1491407/EUSS_TFG_2021-2022/README.md

# TFG
Repositirio del TFG (Trabajo Fin de Grado) de Héctor Bohé Navarrete de la EUSS

# Maqueta de convertidores DC/DC controlados por microcontrolador 
- AUTOR: Héctor Bohé Navarrete - 1491407@campus.euss.org
- TITULACIÓN: Enginyeria Electrònica Industrial i Automàtica
- TUTOR: Carlos Ortega
- [EUSS](https://www.euss.cat/) (Escola Universitària Salesiana de Sarrià)

## Resumen
Este proyecto se desarrolla por la necesidad de realizar prácticas en la asignatura electrónica de potencia donde se analizan diferentes convertidores DC/DC. Se plantea el diseño de una maqueta con un convertidor buck y otro boost pudiendo modificar sus parámetros como frecuencia o ciclo de trabajo utilizando un microcontrolador.
Para ello se estudian los principios de funcionamiento, se realizan los cálculos y posteriormente el diseño con componentes comerciales de ambos convertidores y de la etapa de control. Calculando los parámetros de los convertidores como la intensidad que circula por la bobina o la tensión de salida. 
También se crea un modelo de simulación utilizando el software Matlab y Simulink y se realiza una comprobación del modelo diseñado. Posteriormente se implementan los diseños y se llevan a cabo las mediciones experimentales de ambos convertidores. 

## Palabras clave
 Electrónica de potencia, Power electronics, buck, boost, DC/DC converter, step converters

## Programas
- Matlab R2021b y Simulink: Se ha utilizado el modulo [Simscape Electrical](https://es.mathworks.com/products/simscape-electrical.html?requestedDomain=), que proporciona bibliotecas de componentes para modelar y simular sistemas electrónicos.
- [Overleaf](https://www.overleaf.com/): Se ha utilizado el compilador **LuLaTex** con la versión de TeX Live *2021*.
- [EasyEDA](https://easyeda.com/): Para el diseño del circuito.
- [TekScope Utility](https://forum.tek.com/viewtopic.php?t=140451): Para capturar desde el osciloscopio.
