1491407/EUSS_TFG_2021-2022/PCB/Imágenes/PCB_3D.png

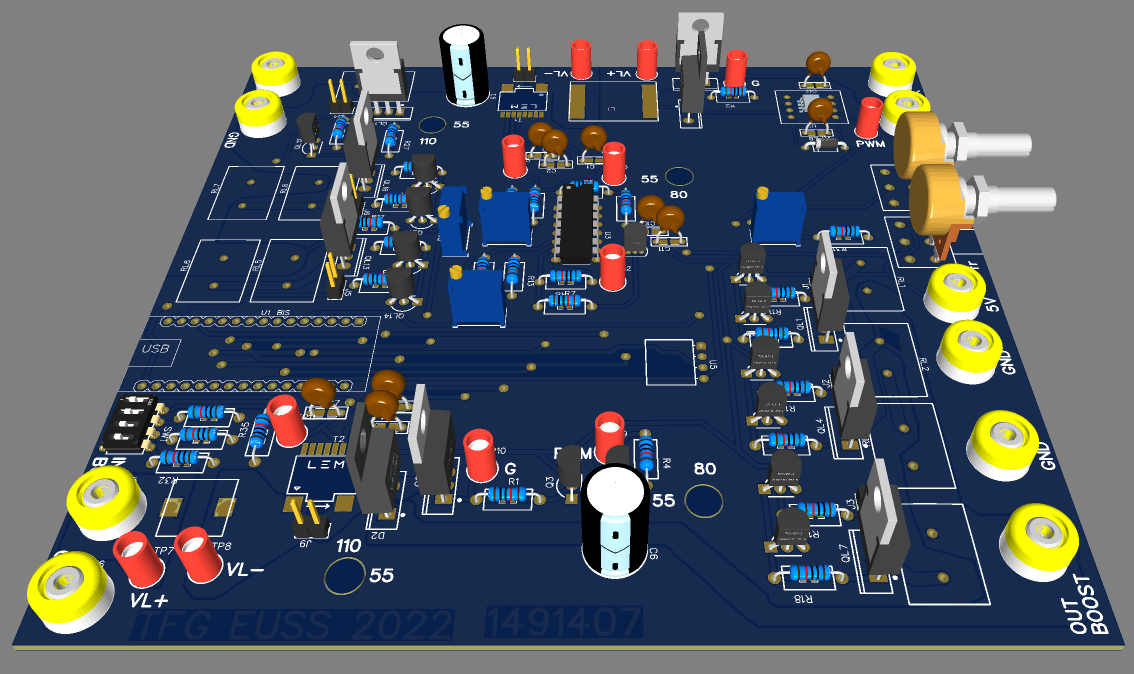
PCB/Imágenes/PCB_3D.png
