1491407/EUSS_TFG_2021-2022/PCB/BOM_TFG.xlsx

ID | Referencia | Descripción | Precio | Importe | Designación | Footprint | Farnell | Ref farnell | Digi-Key | Ref Digi-Key | Mouser | Ref Mouser
1 | 4.7n | Condensador ceramico 4.7nF X7R 0603 50V | 0.008 | 0.016 | C1,C7 | TFG_CAP-7.2*2.5+SMD_0603+0805
2 | 47n | Condensador ceramico 47nF X7R 0603 50V | 0.013 | 0.052 | C2,C3,C4,C9 | TFG_CAP-7.2*2.5+SMD_0603+0805
3 | 100YXF100MEFC12.5X20 | Condensador electrolítico 100uF 100V | 0.58 | 1.16 | C5,C6 | CAP-TH_BD10.0-P5.00-D1.0-FD | https://es.farnell.com/rubycon/100yxf100mefc12-5x20/conden-100-f-100v-20/dp/1144642 | 1144642 | https://www.digikey.es/es/products/detail/rubycon/100YXF100MEFC12-5X20/3564027 | 1189-3674-ND | https://www.mouser.es/ProductDetail/Rubycon/100YXF100MEFC125X20?qs=T3oQrply3y8X5aURr3sYzg%3D%3D | 232-YXF100MEFC125X20
4 | 100n | Condensador ceramico 100nF X7R 0603 50V | 0.039 | 0.078 | C8,C12 | TFG_CAP-7.2*2.5+SMD_0603+0805
5 | 1u | Condensador ceramico 1uF X7R 0603 25V | 0.84 | 0.84 | C10 | TFG_CAP-7.2*2.5+SMD_0603+0805
6 | 0.1u | Condensador ceramico 0.1uF X7R 0603 50V | 0.035 | 0.035 | C11 | TFG_CAP-7.2*2.5+SMD_0603+0805
7 | MBR10100-M3/4W | MBR10100-M3/4W - Diodo shottky 100V 10A TO220AC | 1.18 | 2.36 | D1,D2 | TO-220AC-2_L10.0-W4.5-P5.08-T | https://es.farnell.com/on-semiconductor/mbr10100g/diode-schottky-10a-100v/dp/9557407?ost=mbr10100g | 9557407 | https://www.digikey.es/es/products/detail/vishay-general-semiconductor-diodes-division/MBR10100-M3-4W/4832798 | MBR10100-M3/4WGI-ND | https://www.mouser.es/ProductDetail/onsemi/MBR10100G?qs=3JMERSakebrmlzTWRmdCeA%3D%3D | 863-MBR10100G
8 | 1N4007-TP | 1N4007-TP - Diodo 1KV 1A DO41 | 0.174 | 0.174 | D4 | DO-41_BD2.4-L4.7-P8.70-D0.9-RD | https://es.farnell.com/diodes-inc/1n4007-t/diodo-rectificador-1000v-1a-do/dp/1843698?st=1n4007 | 1843698 | https://www.digikey.es/es/products/detail/micro-commercial-co/1N4007-TP/773694 | 1N4007-TPMSCT-ND | https://www.mouser.es/ProductDetail/Diotec-Semiconductor/1N4007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 | 637-1N4007
9 | Banana M6 | Banan M6 | 1.03 | 10.3 | H1 | TFG_BANANA
10 | JUMPER | JUMPER - Jumper 2.54mm | 0.027 | 0.243 | J1,J2,J3,J4,J5,J6,J7,J8,J9 | HDR-TH_2P-P2.54-V-M-1
11 | IHLP6767GZER680M11 | 68uH - Bobina 68uH 7.7A SMD | 4.25 | 4.25 | L1 | IHLP6767GZER100M8A | https://es.farnell.com/vishay/ihlp6767gzer680m11/inductor-68uh-6-1a-20-smd/dp/1845600 | 1845600 | https://www.digikey.es/es/products/detail/vishay-dale/IHLP6767GZER680M11/2139397 | 541-1292-1-ND | https://www.mouser.es/ProductDetail/Vishay-Dale/IHLP6767GZER680M11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 | 70-IHLP6767GZER680M1
12 | SRP1040VA-220M | 22uH - Bobina 22uH 7.5A SMD | 2.03 | 2.03 | L2 | SRP1040VA | https://es.farnell.com/bourns/srp1040va-220m/inductor-aec-q200-22uh-blindado/dp/3385403 | 3385403 | https://www.digikey.es/es/products/detail/bourns-inc/SRP1040VA-220M/11656177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 | 118-SRP1040VA-220MCT-ND | https://www.mouser.es/ProductDetail/Bourns/SRP1040VA-220M?qs=OlC7AqGiEDl3Cs4p%2FLq6Bg%3D%3D | 652-SRP1040VA-220M
13 | IRLZ44NPBF | IRLZ44 - Mosfet canal-N 55V 47A TO220AB | 1.134 | 9.072 | Q1,Q2,QL1,QL4,QL7,QL10,QL13,QL16 | TO-220-3_L10.0-W4.5-P2.54-L | https://es.farnell.com/vishay/irlz44pbf/mosfet-n-ch-60v-50a-to-220/dp/3772732?st=irlz44 | 3772732 | https://www.digikey.es/es/products/detail/infineon-technologies/IRLZ44NPBF/811808 | IRLZ44NPBF-ND | https://www.mouser.es/ProductDetail/Vishay-Semiconductors/IRLZ44PBF?qs=cvaI6Thkwxs%2F%2FLKnrdRUbA%3D%3D | 844-IRLZ44PBF
14 | 2N5551TA | 2N5551TA - Transistor NPN 160V 600mA TO92-3 | 0.284 | 1.988 | Q3,QL2,QL6,QL8,QL11,QL14,QL17 | TO-92-3_L4.8-W3.7-P2.54-L | https://es.farnell.com/on-semiconductor/2n5551ta/transistor-bipol-npn-160v-to-92/dp/2453758?st=2n5551ta | 2453758 | https://www.digikey.es/es/products/detail/onsemi/2N5551TA/3478145 | 2N5551TAFSCT-ND | https://www.mouser.es/ProductDetail/onsemi-Fairchild/2N5551TA | 512-2N5551TA
15 | 2N4403TAR | 2N4403TAR - Transistor PNP 40V 600mA TO92-3 | 0.292 | 2.044 | Q4,QL3,QL5,QL9,QL12,QL15,QL18 | TO-92-3_L4.8-W3.7-P2.54-L | https://es.farnell.com/on-semiconductor/2n4403tar/pnp-bipolar-junction-transistor/dp/3615144?ost=2n4403tar | 3615144 | https://www.digikey.es/es/products/detail/onsemi/2N4403TAR/4314795 | 2N4403TARCT-ND | https://www.mouser.es/ProductDetail/onsemi-Fairchild/2N4403TAR?qs=nkpohTZxueNuessh%2FKQApA%3D%3D | 512-2N4403TAR
16 | 27 | Resitencia axial 27ohm 1/4W | 0.17 | 1.36 | R1,R2,R12,R15,R18,R21,R24,R27 | TFG_R_AXIAL-0.6+SMD_0603
17 | 100k | Resitencia axial 100kohm 1/4W | 0.17 | 1.02 | R3,R7,R9,R13,R17,R31 | TFG_R_AXIAL-0.6+SMD_0603
18 | 1k | Resitencia axial 1kohm 1/4W | 0.17 | 1.19 | R4,R11,R16,R19,R20,R23,R28 | TFG_R_AXIAL-0.6+SMD_0603
19 | 680k | Resitencia axial 680kohm 1/4W | 0.17 | 0.68 | R5,R6,R8,R10 | TFG_R_AXIAL-0.6+SMD_0603
20 | 3296W-1-253LF | Potenciometro multivuelta 25kohm 25vueltas | 0.87 | 3.48 | R14,R22,R25,R26 | RES-ADJ-TH_3P-L9.5-W4.9-P2.50-L_3296W
21 | PDB182-K220K-104B | PDB182-K220K-104B - Potenciometro 100K 1/8W LINEAL | 1.93 | 3.86 | R29,R30 | TFG_POTENCIOMETRO | https://es.farnell.com/bourns/pdb182-k220k-104b/panel-control-1-turn-100k/dp/1689955 | 1689955 | https://www.digikey.es/es/products/detail/bourns-inc/PDB182-K220K-104B/699765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 | PDB182-K220K-104B-ND | https://www.mouser.es/ProductDetail/Bourns/PDB182-K220K-104B?qs=Ivs1Be2ZGq5w5ayg3Iig0w%3D%3D | 652-PDB182-K220K104B
22 | 4k7 | Resitencia axial 27ohm 1/4W | 0.17 | 0.68 | R32,R33,R34,R35 | TFG_R_AXIAL-0.6+SMD_0603
23 | 1 | Resitencia potencia 39ohm 10W | 0.84 | 0.84 | RL | SQMW10S
24 | 10 | Resitencia potencia 10ohm 10W | 0.84 | 6.72 | RL1,RL2,RL3,RL4,RL5,RL6,RL7,RL8 | SQMW10S
25 | DIP switchEI-04 | Switch 3 posiciones | 1.67 | 1.67 | SW1 | SW-TH_DIPSWITCHEI-04
26 | HMSR 6-SMS (LEM) | HMSR 6-SMS (LEM) - Sensor de corriente 6A | 6.024 | 12.048 | T1,T2 | HMSR SERIES-SMS (LEM) | https://es.farnell.com/lem/hmsr-6-sms/sensor-de-corriente-300khz-soic/dp/3796476?st=hmsr%206-sms | 3796476 | https://www.digikey.es/es/products/detail/lem-usa-inc/HMSR-6-SMS/12686351 | 398-HMSR6-SMSCT-ND | - | -
27 | ARDUINO | Arduino Nano | 8.94 | 8.94 | U1 | ARDUINO-NODIM
28 | IR2301SPBF | IR2301SPBF - Driver HI/LOW 8SOIC | 1.87 | 1.87 | U2 | TEST_SOIC8 | https://es.farnell.com/infineon/ir2301spbf/controlador-mosfet-high-low-2301/dp/8639060?ost=ir2301spbf | 8639060 | https://www.digikey.es/es/products/detail/infineon-technologies/IR2301SPBF/856525 | IR2301SPBF-ND | https://www.mouser.es/ProductDetail/Infineon-IR/IR2301SPBF?qs=sGAEpiMZZMsAvJ0ncm7vm1QW4cB7Ovfg | 942-IR2301SPBF
29 | MCP1525-I/TO | MCP1525-I/TO - VREF 2.5V TO92-3 | 0.97 | 0.97 | U4 | TO-92-3_L4.9-W3.7-P1.27-L | https://es.farnell.com/microchip/mcp1525-i-to/ref-de-tensi-n-serie-2-5v-to-226aa/dp/1292235 | 1292235 | https://www.digikey.es/es/products/detail/microchip-technology/MCP1525-I-TO/443708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 | MCP1525-I/TO-ND | https://www.mouser.es/ProductDetail/Microchip-Technology/MCP1525-I-TO?qs=sGAEpiMZZMsVgcksf1EMUmaIuL6OBSmN | 579-MCP1525ITO
30 | DW254W-11-04-85 | DW254W-11-04-85 - Tira pin | 0.4 | 0.4 | U5 | HDR-TH_4P-P2.54-H-F-W10.3-N
31 | TL084 | TL084 - Amplificador operacional | 2.87 | 2.87 | U3 | PDIP-14_L19.7-W6.6-P2.54-LS8.3-BL
