1491407/EUSS_TFG_2021-2022/Simulación/resultados/Buck-CCM.pdf

### Valores del circuito


### Cargas

modo = 'Buck-CCM';
Rl=2;

Vi=30;
D=1/6;
f=31250;
L=68e-6;
C=100e-6;

T=1/f;

### Simulink

Ejecutamos el modelo de simulink

tstop=223*T;
%out=sim("circuito_boost.slx", tstop); out=sim("circuito_buck.slx", tstop);

### Graficas

Ahora generamos las graficas

inicio=220*T;
final=223*T;

tiledlayout(8,1)

situacion=[sprintf(' [%s R=%0.1f',modo,Rl) ' \Omega]']; modo=strcat(modo, '-graficas');
ejex='t[s]';
sizetext=8;

% Tensió salida
ax1 = nexttile;
titulo='Tensión salida';

ejey='Vout[V]';
titulo=[titulo situacion]; TFGPlot(ax1,out.t,out.v_out,inicio,final,titulo,ejex,ejey,sizetext);

% Corriente salida
ax2 = nexttile;
titulo='Corriente salida';
ejey='iout[V]';
titulo=[titulo situacion]; TFGPlot(ax2,out.t,out.i_out,inicio,final,titulo,ejex,ejey,sizetext);

% Tensió bobina
ax3 = nexttile;
titulo='Tensión bobina';
ejey='Vl[V]';
titulo=[titulo situacion]; TFGPlot(ax3,out.t,out.v_l,inicio,final,titulo,ejex,ejey,sizetext);

% Corriente bobina
ax4 = nexttile;
titulo='Corriente bobina';
ejey='il[A]';
titulo=[titulo situacion]; TFGPlot(ax4,out.t,out.i_l,inicio,final,titulo,ejex,ejey,sizetext);

% Tensión diodo
ax5 = nexttile;
titulo='Tensión diodo';
ejey='Vd[V]';
titulo=[titulo situacion]; TFGPlot(ax5,out.t,out.v_d,inicio,final,titulo,ejex,ejey,sizetext);

% Corriente diodo
ax6 = nexttile;
titulo='Corriente diodo';
ejey='id[V]';
titulo=[titulo situacion]; TFGPlot(ax6,out.t,out.i_d,inicio,final,titulo,ejex,ejey,sizetext);

% tension condensador
ax7 = nexttile;
titulo='Tensión condensador';
ejey='Vc[V]';
titulo=[titulo situacion]; TFGPlot(ax7,out.t,out.v_c,inicio,final,titulo,ejex,ejey,sizetext);

% Corrienet condensador
ax8 = nexttile;
titulo='Corriente condensador';
ejey='ic[V]';
titulo=[titulo situacion]; TFGPlot(ax8,out.t,out.i_c,inicio,final,titulo,ejex,ejey,sizetext);

Guardamos el grafico en pdf

print(modo,'-dpdf','-fillpage')

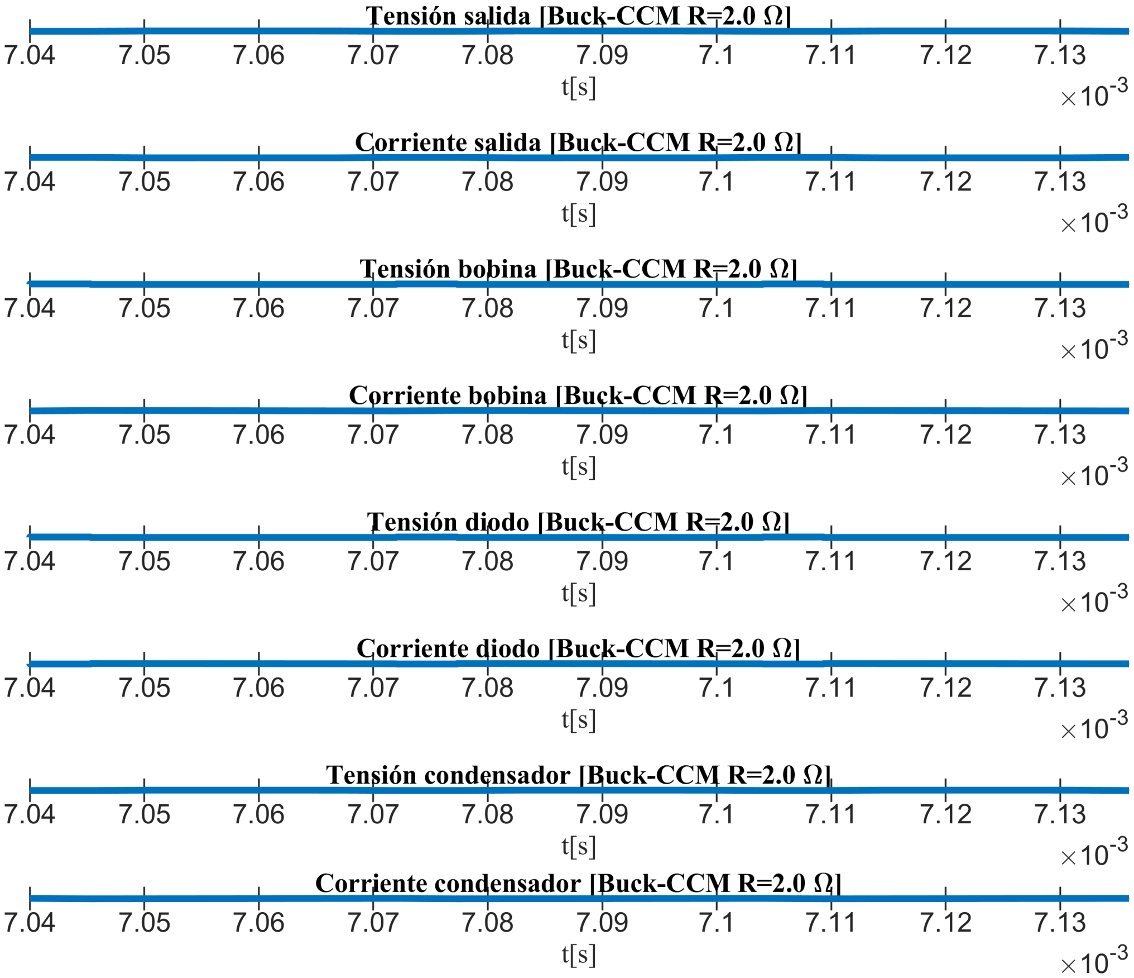
[picture p91: figure]

Buscamos maximos y minimos

posTinicio=find(out.t==inicio,1,"first"); posTfinal=find(out.t==final,1,"first"); % Tensió salida
v_out=out.v_out(posTinicio:posTfinal); v_ou_max=max(v_out)

v_ou_max = 4.3413
v_out_min=min(v_out)

v_out_min = 4.2973
% Corriente salida
i_out=out.i_out(posTinicio:posTfinal); i_out_max=max(i_out)

i_out_max = -2.1487
i_out_min=min(i_out)

i_out_min = -2.1707
% Tensió bobina
v_l=out.v_l(posTinicio:posTfinal);

v_l_max=max(v_l)

v_l_max = 25.5812
v_l_min=min(v_l)

v_l_min = -5.1441
% Corriente bobina
i_l=out.i_l(posTinicio:posTfinal); i_l_max=max(i_l)

i_l_max = 3.1670
i_l_min=min(i_l)

i_l_min = 1.1621
I_L=((max(i_l)-min(i_l))/2)+min(i_l)

I_L = 2.1645
% Tensión diodo
v_d=out.v_d(posTinicio:posTfinal); v_d_max=max(v_d)

v_d_max = 29.8786
v_d_min=min(v_d)

v_d_min = -0.8032
% Corriente diodo
i_d=out.i_d(posTinicio:posTfinal); i_d_max=max(i_d)

i_d_max = 3.1667
i_d_min=min(i_d)

i_d_min = -0.0522
% tension condensador
v_c=out.v_c(posTinicio:posTfinal); v_c_max=max(v_c)

v_c_max = 4.3413
v_c_min=min(v_c)

v_c_min = 4.2973
% Corrienet condensador
i_c=out.i_c(posTinicio:posTfinal); i_c_max=max(i_c)

i_c_max = 0.9866
i_c_min=min(i_c)

i_c_min = -1.0179
