1491407/EUSS_TFG_2021-2022/PCB/Schematic_TFG.pdf

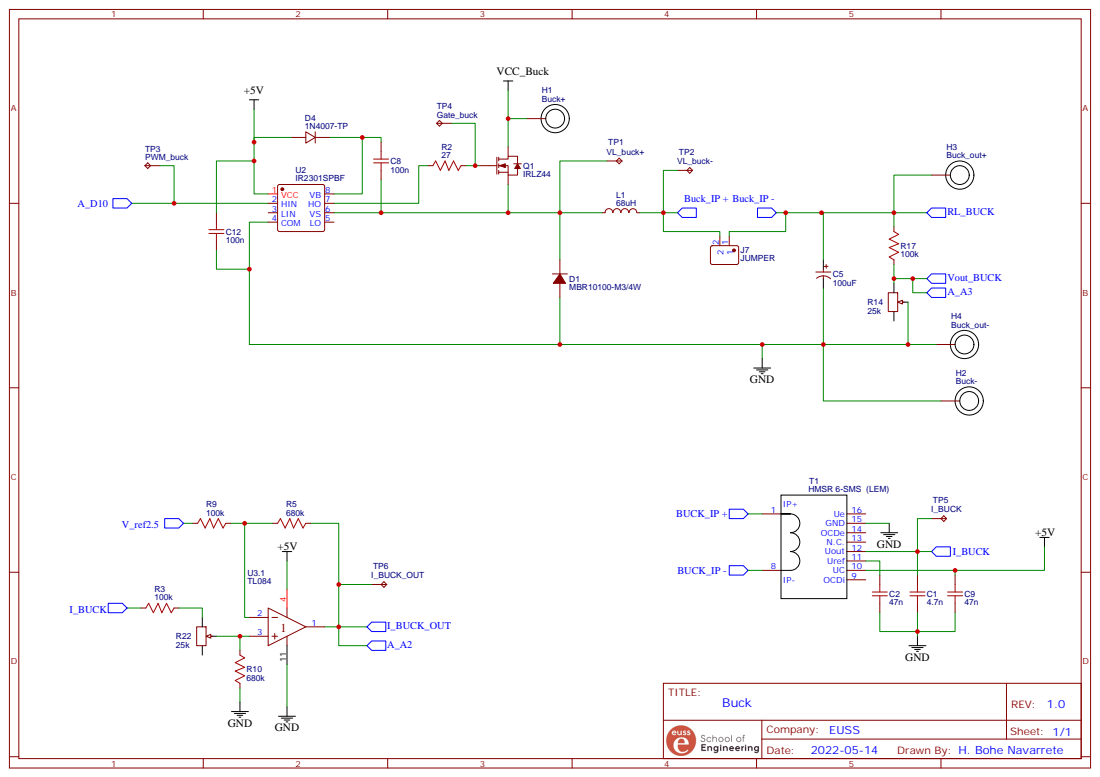
[picture p92: page 1]

UC 10 Uref 11 Uout 12 N.C. 13 OCDe 14 GND 15 Ue 16

Drawn By: H. Bohe Navarrete

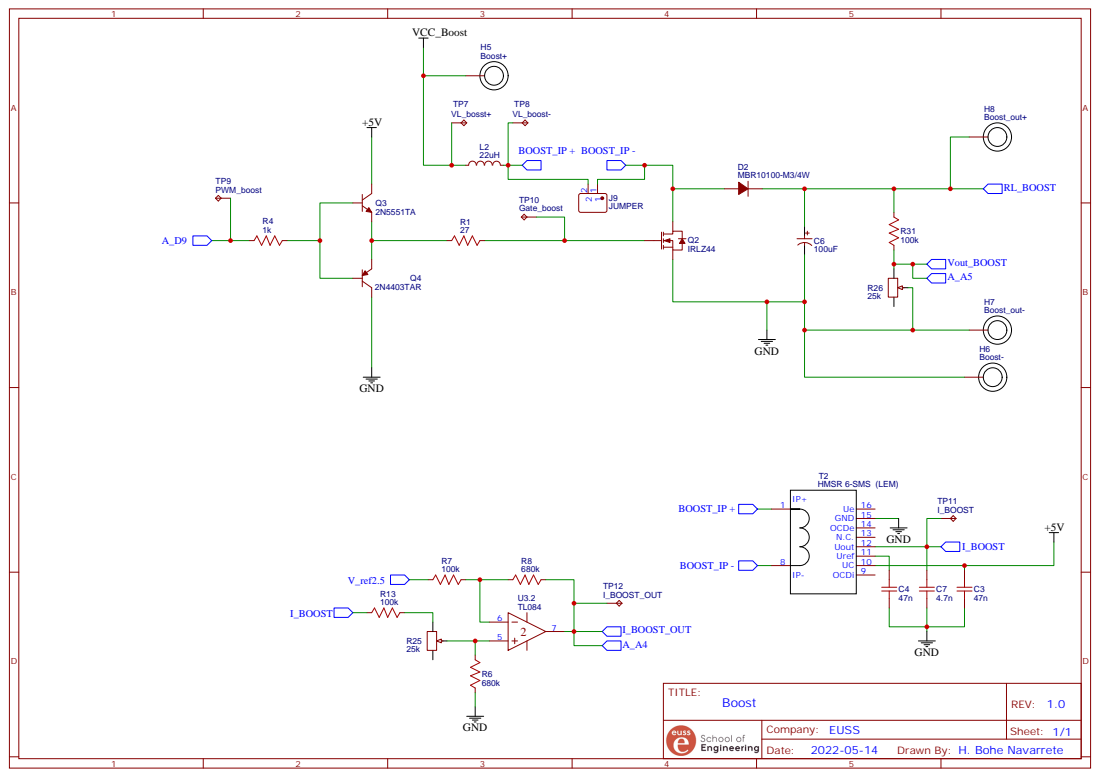
[picture p93: page 2]

UC 10 Uref 11 Uout 12 N.C. 13 OCDe 14 GND 15 Ue 16

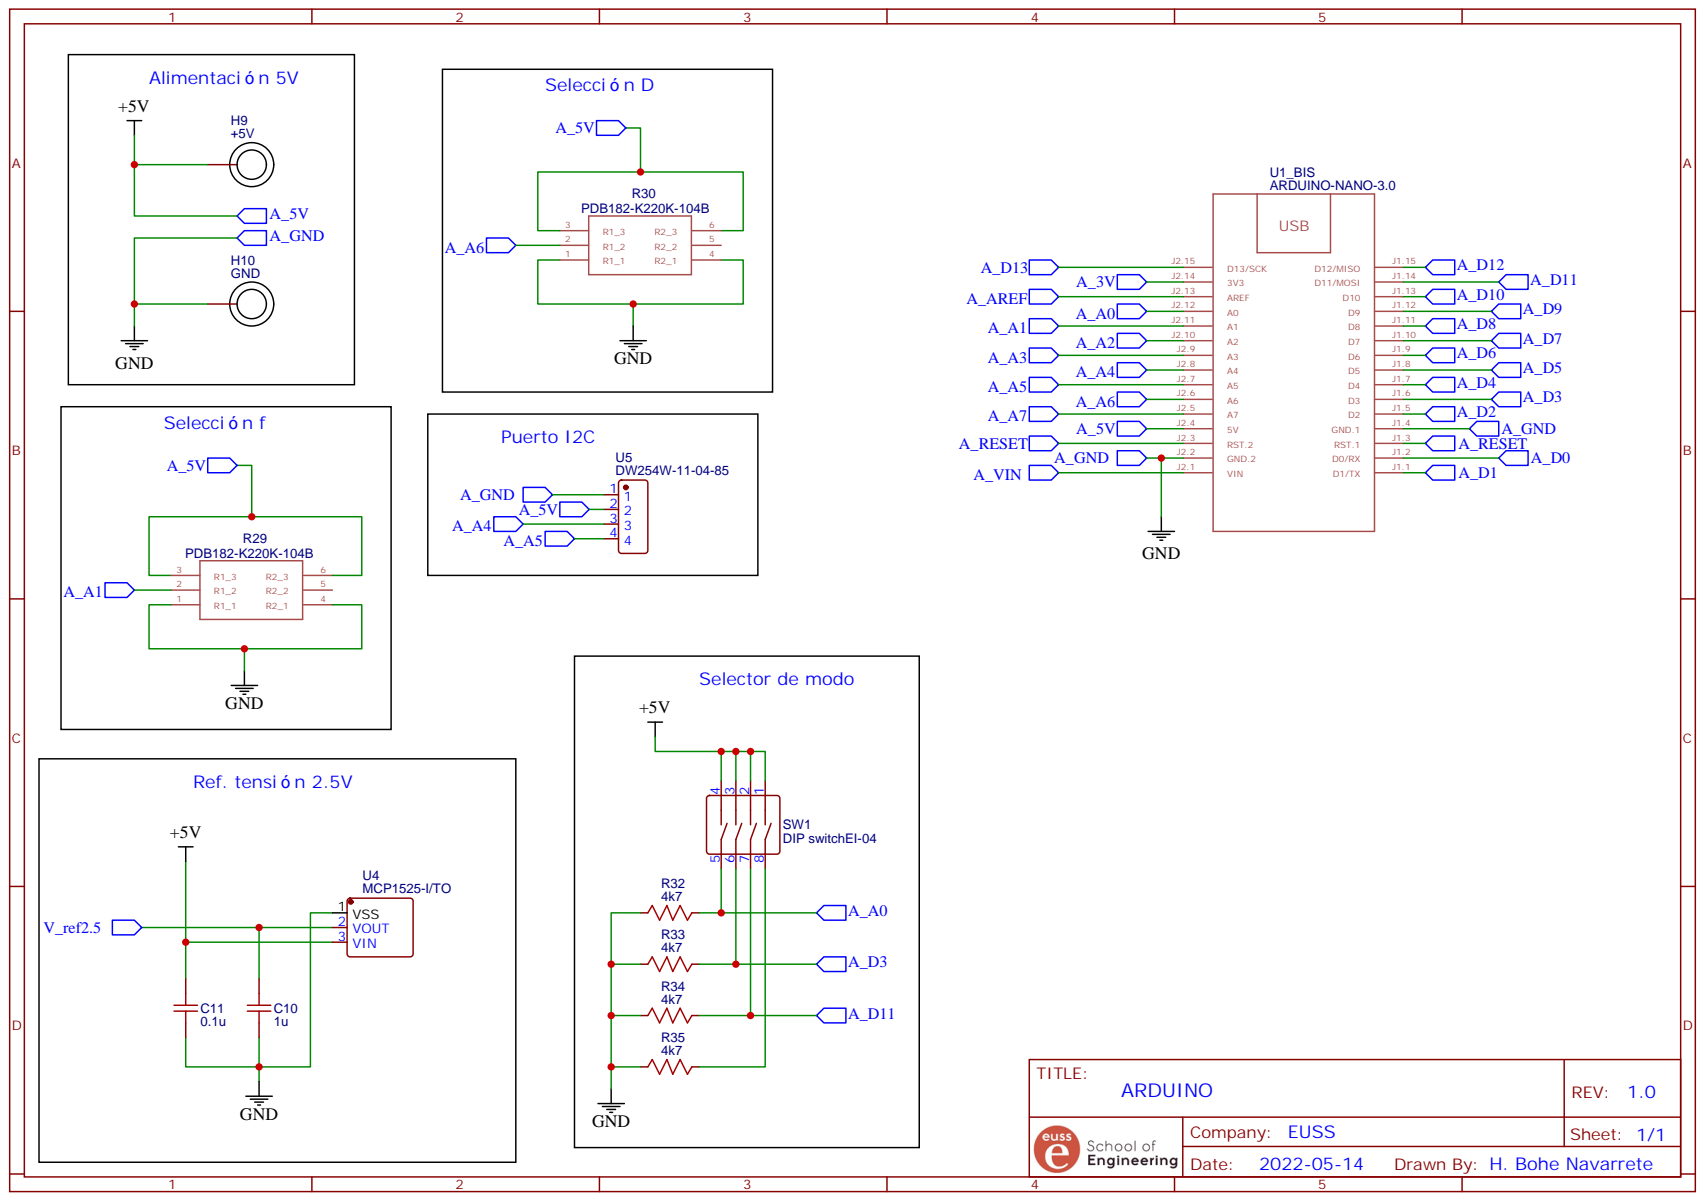
[picture p94: page 3]

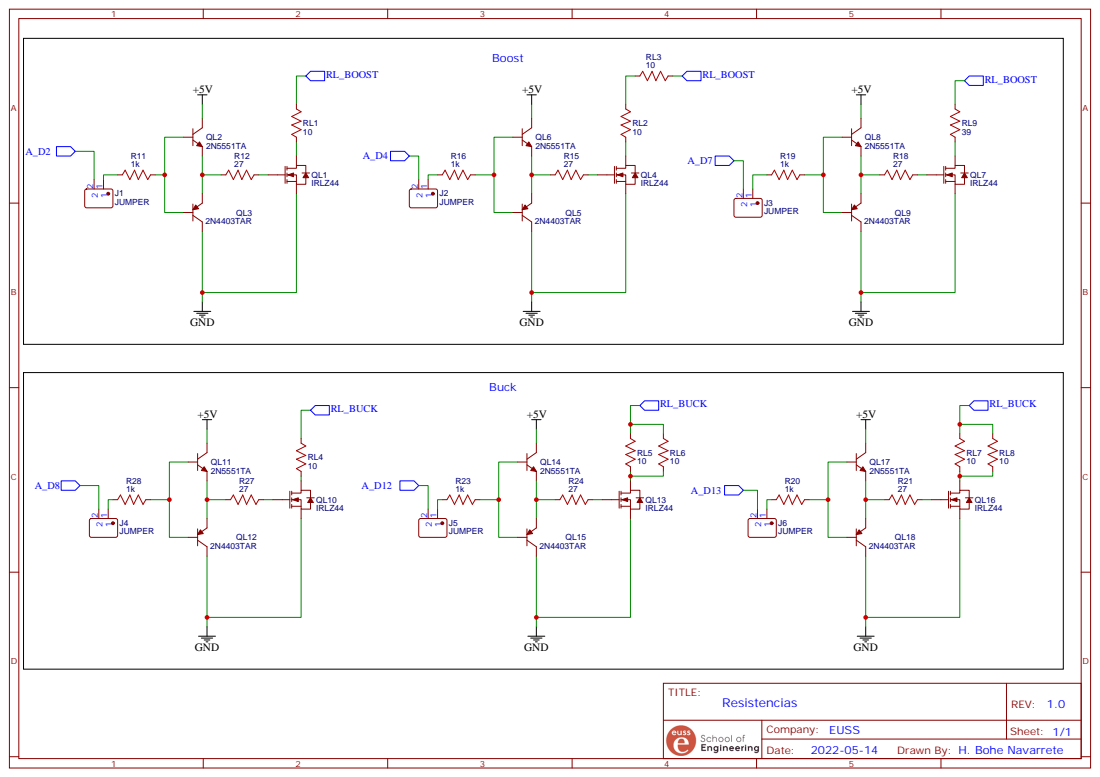
[picture p95: page 4]
