1491407/EUSS_TFG_2021-2022/Simulación/resultados/Buck-CCM-graficas.pdf

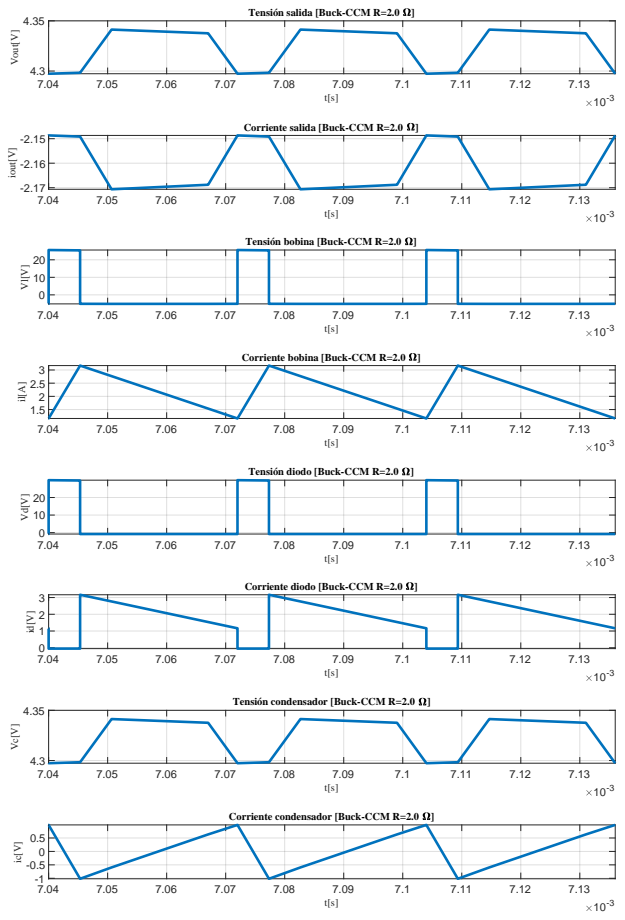
[picture p96: page 1]
Vout[V]; iout[V]

Tensión salida [Buck-CCM R=2.0 ]

Corriente salida [Buck-CCM R=2.0 ]

Tensión bobina [Buck-CCM R=2.0 ]

Corriente bobina [Buck-CCM R=2.0 ]

Tensión diodo [Buck-CCM R=2.0 ]

Corriente diodo [Buck-CCM R=2.0 ]

Tensión condensador [Buck-CCM R=2.0 ]

Corriente condensador [Buck-CCM R=2.0 ]
