1491407/EUSS_TFG_2021-2022/Simulación/resultados/Buck-DCM-graficas.pdf

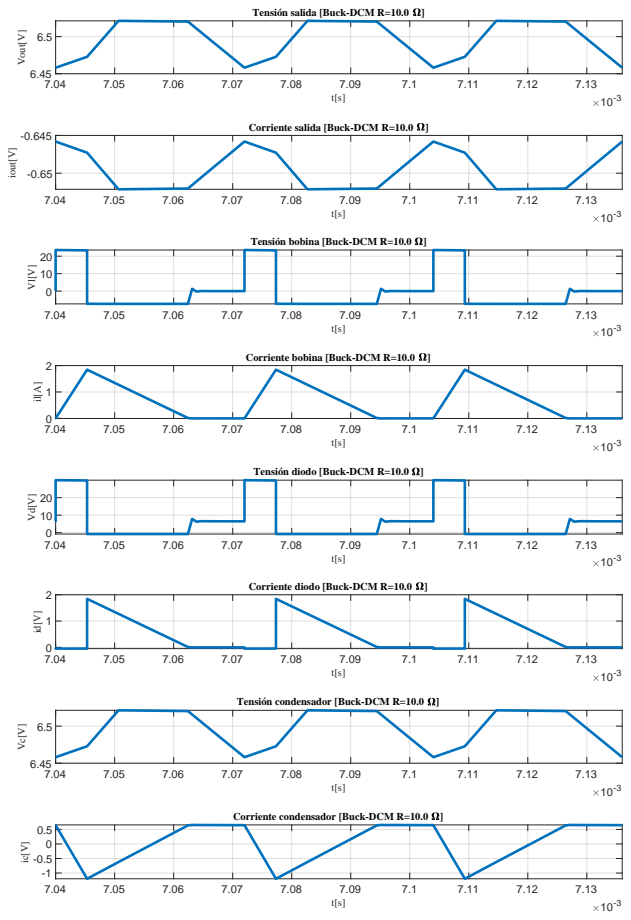
[picture p97: page 1]
Vout[V]; iout[V]

Tensión salida [Buck-DCM R=10.0 ]

Corriente salida [Buck-DCM R=10.0 ]

Tensión bobina [Buck-DCM R=10.0 ]

Corriente bobina [Buck-DCM R=10.0 ]

Tensión diodo [Buck-DCM R=10.0 ]

Corriente diodo [Buck-DCM R=10.0 ]

Tensión condensador [Buck-DCM R=10.0 ]

Corriente condensador [Buck-DCM R=10.0 ]
