1491407/EUSS_TFG_2021-2022/Simulación/resultados/Buck-Limite-graficas.pdf

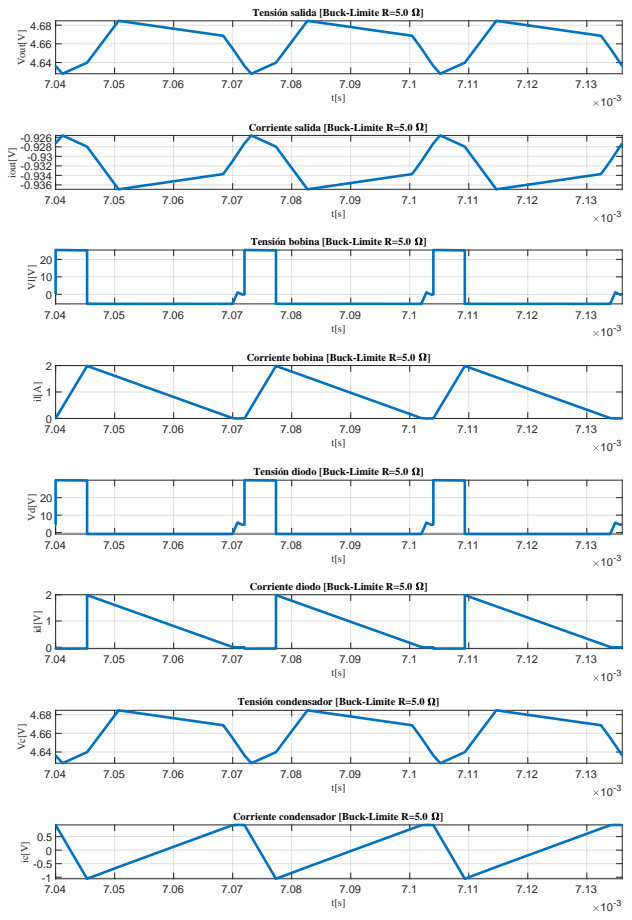
[picture p98: page 1]
Vout[V]; iout[V]

Tensión salida [Buck-Limite R=5.0 ]

Corriente salida [Buck-Limite R=5.0 ]

Tensión bobina [Buck-Limite R=5.0 ]

Corriente bobina [Buck-Limite R=5.0 ]

Tensión diodo [Buck-Limite R=5.0 ]

Corriente diodo [Buck-Limite R=5.0 ]

Tensión condensador [Buck-Limite R=5.0 ]

Corriente condensador [Buck-Limite R=5.0 ]
