1491407/EUSS_TFG_2021-2022/Simulación/resultados/circuito_buck.pdf

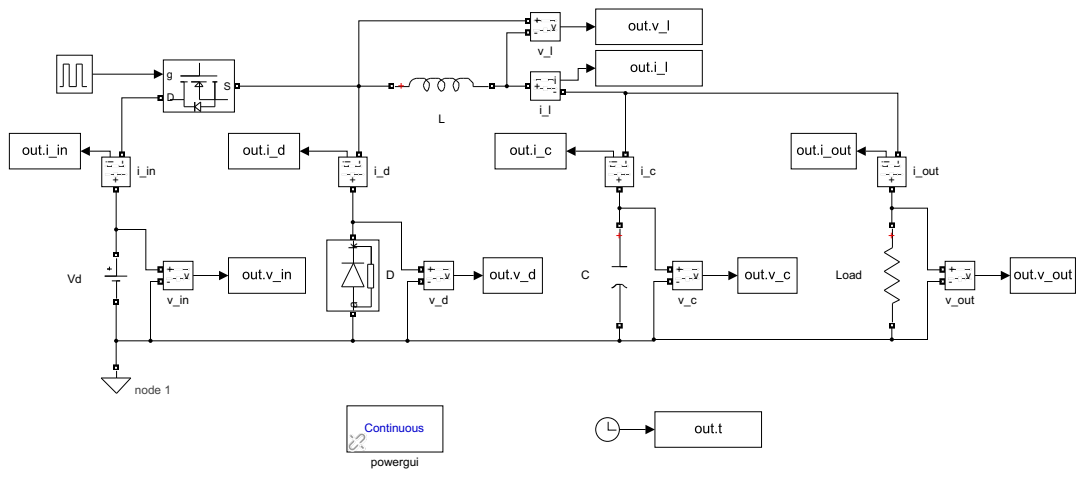
[picture p99: page 1]
+ - v_out; Load; Continuous; powergui; i_out; node 1
