1491407/EUSS_TFG_2021-2022/Simulación/resultados/Boost-Caso limite-graficas.pdf

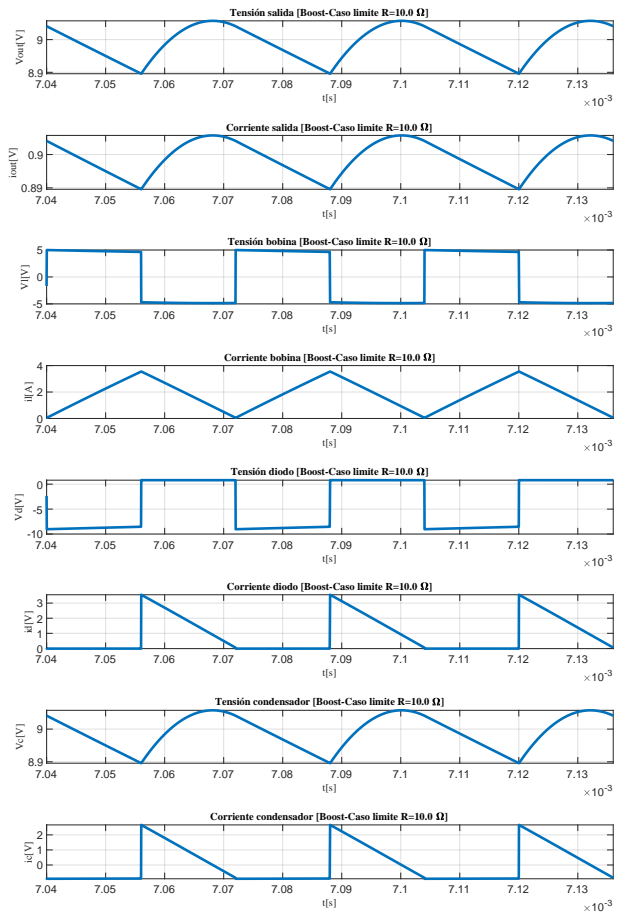
[picture p100: page 1]
Vout[V]; iout[V]

Tensión salida [Boost-Caso limite R=10.0 ]

Corriente salida [Boost-Caso limite R=10.0 ]

Tensión bobina [Boost-Caso limite R=10.0 ]

Corriente bobina [Boost-Caso limite R=10.0 ]

Tensión diodo [Boost-Caso limite R=10.0 ]

Corriente diodo [Boost-Caso limite R=10.0 ]

Tensión condensador [Boost-Caso limite R=10.0 ]

Corriente condensador [Boost-Caso limite R=10.0 ]
