1491407/EUSS_TFG_2021-2022/Simulación/resultados/Boost-CCM-graficas.pdf

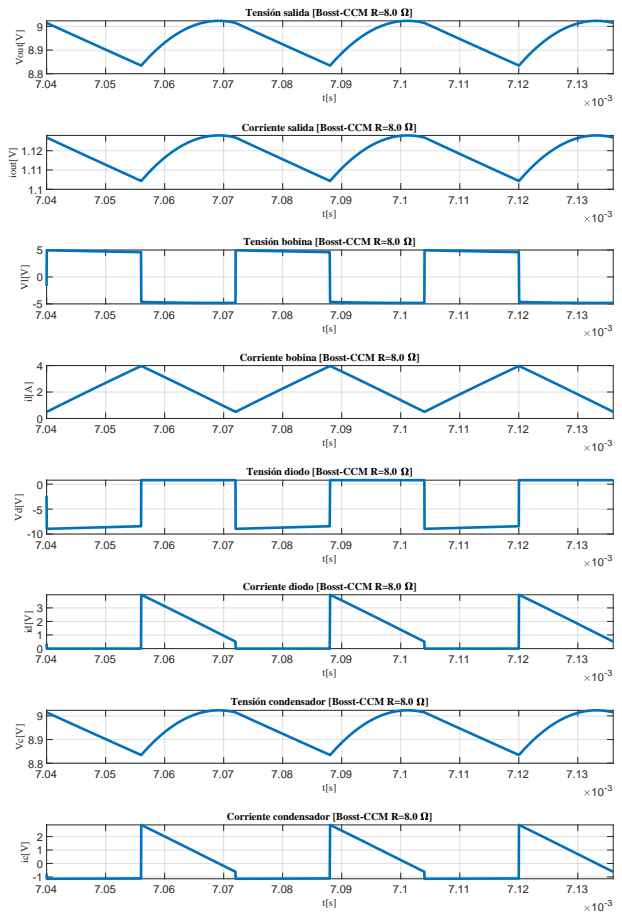
[picture p101: page 1]
Vout[V]; iout[V]

Tensión salida [Bosst-CCM R=8.0 ]

Corriente salida [Bosst-CCM R=8.0 ]

Tensión bobina [Bosst-CCM R=8.0 ]

Corriente bobina [Bosst-CCM R=8.0 ]

Tensión diodo [Bosst-CCM R=8.0 ]

Corriente diodo [Bosst-CCM R=8.0 ]

Tensión condensador [Bosst-CCM R=8.0 ]

Corriente condensador [Bosst-CCM R=8.0 ]
