1491407/EUSS_TFG_2021-2022/Simulación/resultados/Boost-DCM-graficas.pdf

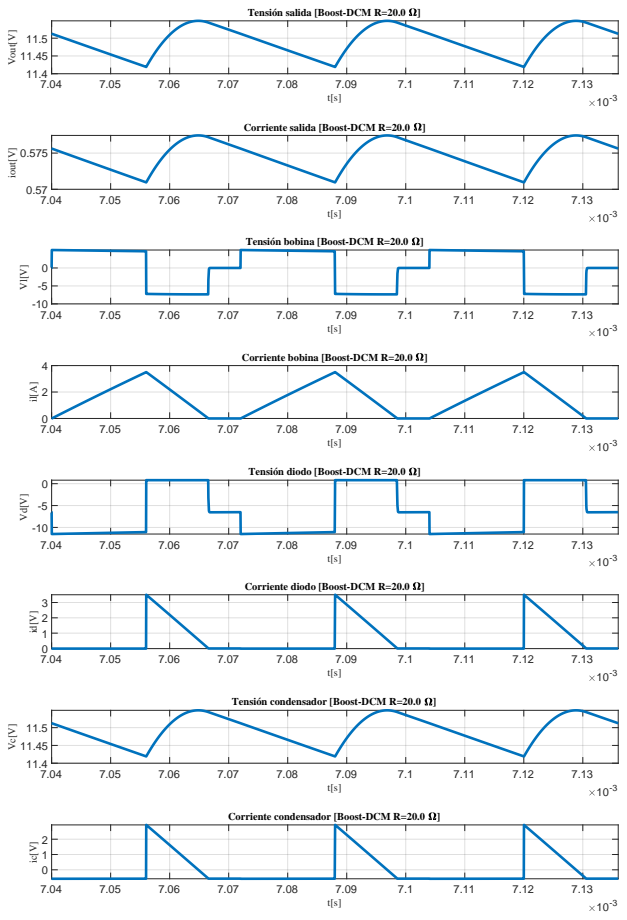
[picture p102: page 1]
Vout[V]; iout[V]

Tensión salida [Boost-DCM R=20.0 ]

Corriente salida [Boost-DCM R=20.0 ]

Tensión bobina [Boost-DCM R=20.0 ]

Corriente bobina [Boost-DCM R=20.0 ]

Tensión diodo [Boost-DCM R=20.0 ]

Corriente diodo [Boost-DCM R=20.0 ]

Tensión condensador [Boost-DCM R=20.0 ]

Corriente condensador [Boost-DCM R=20.0 ]
