1491407/EUSS_TFG_2021-2022/Simulación/resultados/circuito_boost.pdf

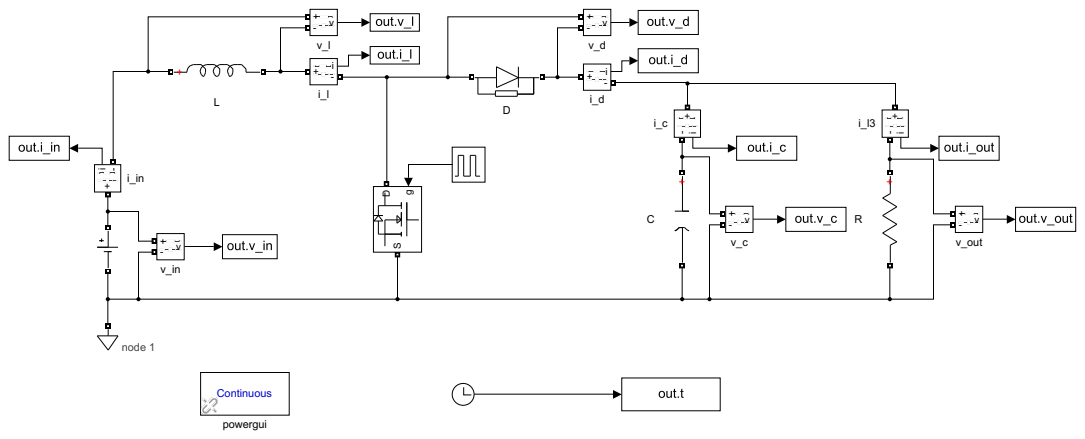
[picture p103: page 1]
tin
