1491407/EUSS_TFG_2021-2022/PCB/Imágenes/PCB_BOTTOM.pdf

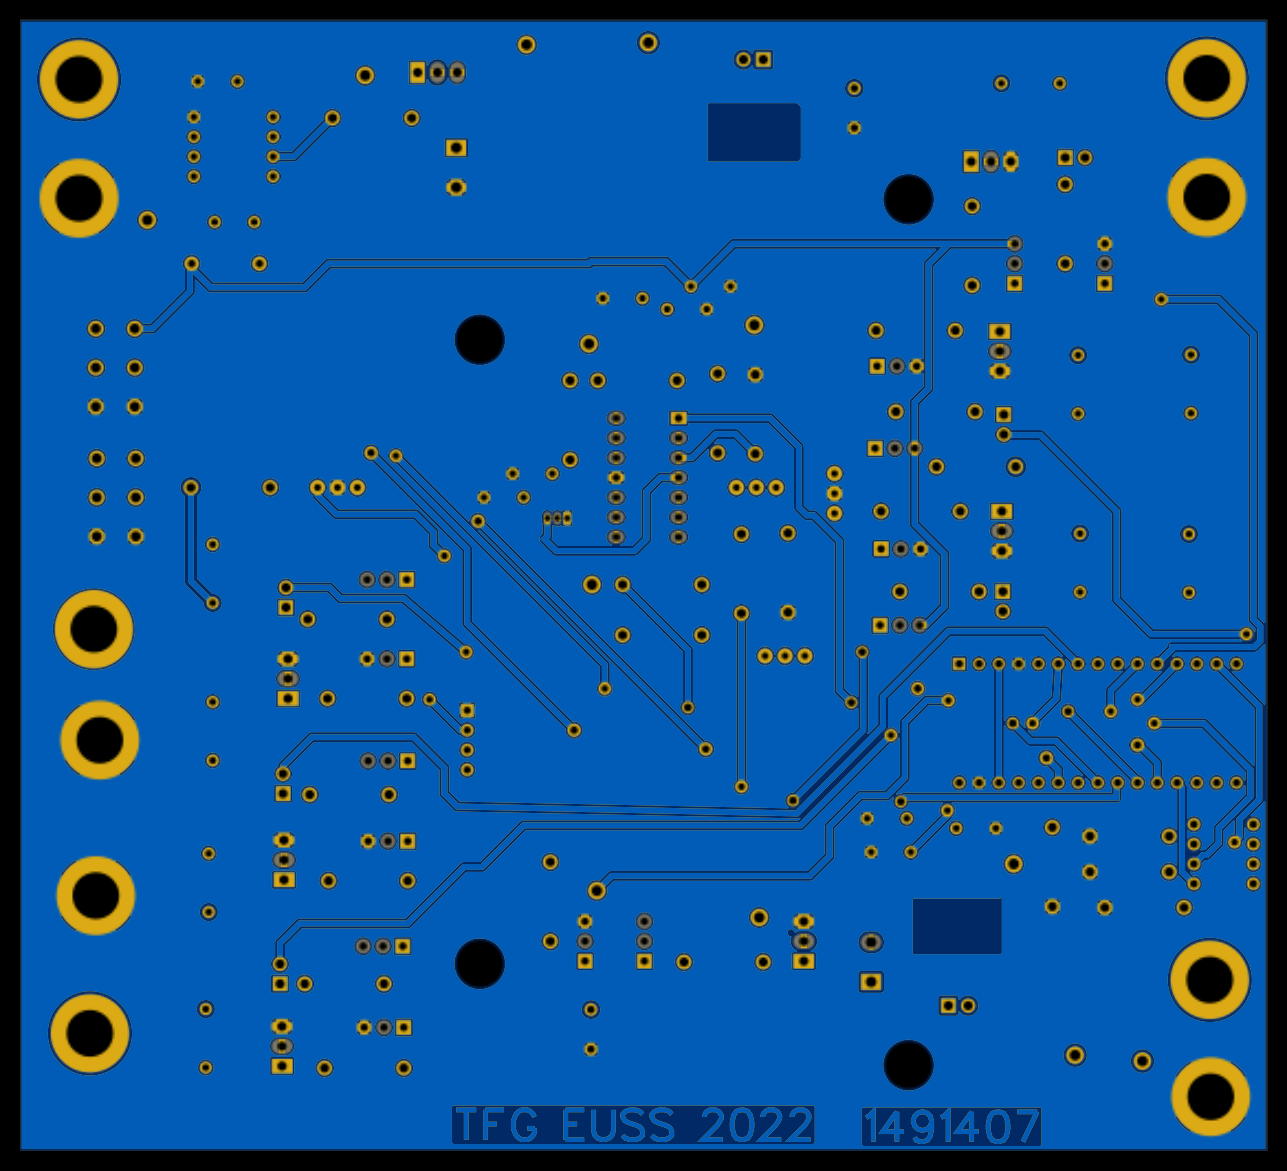
[picture p104: page 1]
