1491407/EUSS_TFG_2021-2022/PCB/Imágenes/PCB_TOP.pdf

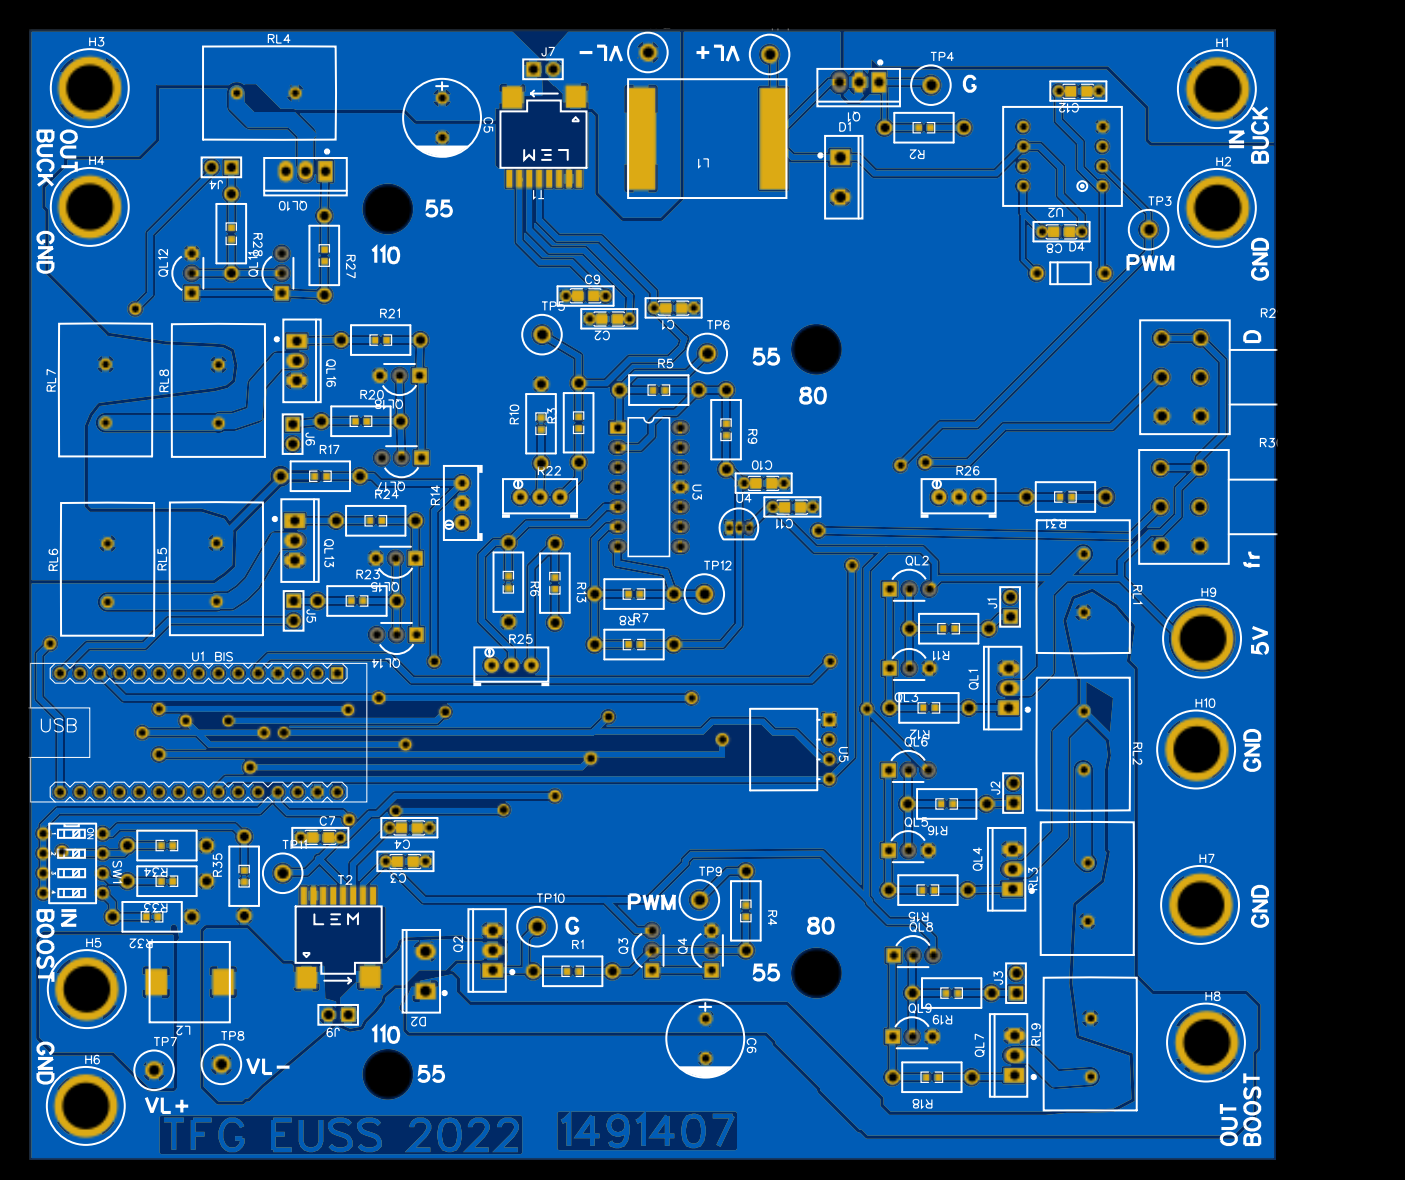
[picture p105: page 1]
