1491407/EUSS_TFG_2021-2022/(list of files, drawings)

Other design files:
PCB/SCH_TFG.json
