1491407/EUSS_TFG_2021-2022/(commit log)

2022-06-13 Programa de ARDUINO
    -Se carga el programa del microcontrolador
2022-06-13 Simulación
    -Carga de archivos de simulación
2022-06-14 Imagen 3D PCB
